zzw200498-hue/stm32-esp8266-iot-gateway/docs/schematic-lceda.pdf

1

2

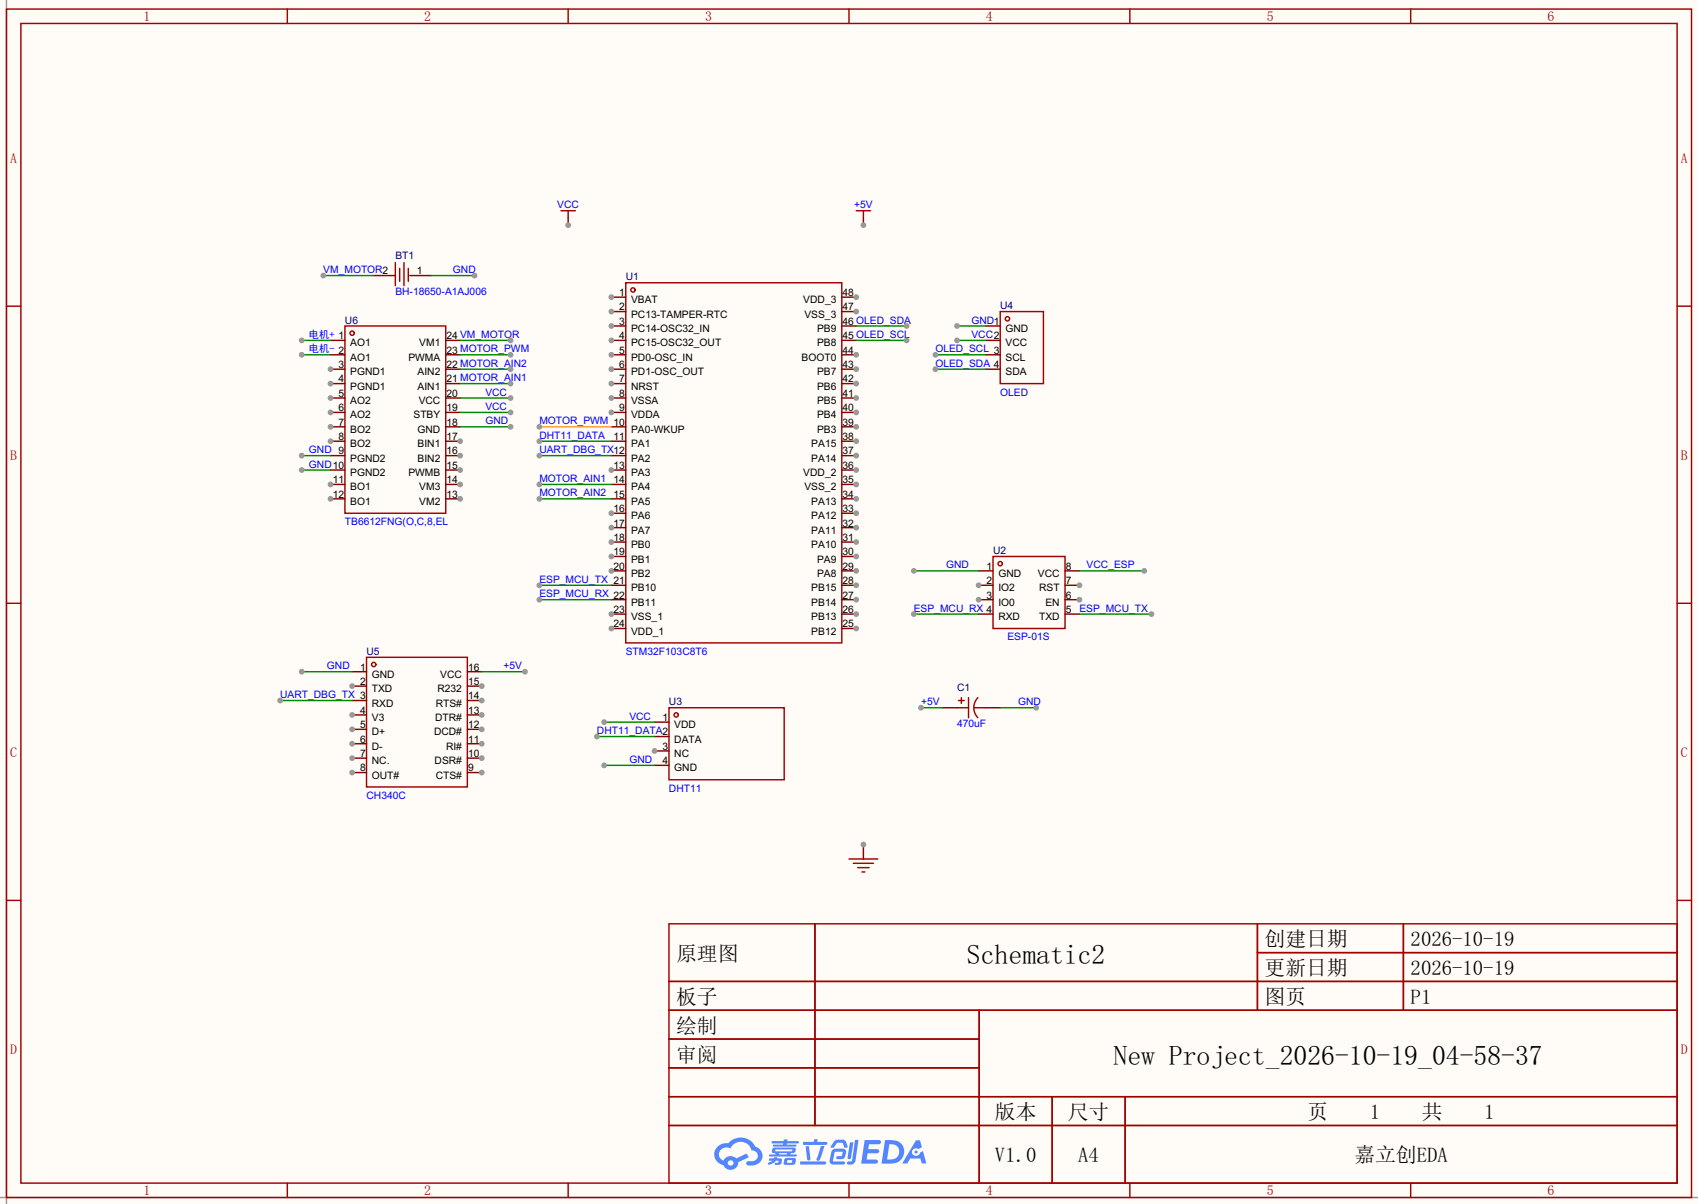
[picture p3: page 1]

ESP_MCU_TX
ESP_MCU_RX
DSR# 10 RI# 11 DCD# 12 DTR# 13 RTS# 14 R232 15 VCC 16

原理图 | Schematic2 | 创建日期 | 2026-10-19

更新日期 | 2026-10-19

板子 | | 图页 | P1
绘制 | | New Project_2026-10-19_04-58-37
审阅

V1.0 | A4 | 嘉立创EDA
