zzw200498-hue/stm32-esp8266-iot-gateway/Hardware/Serial.c

#include "stm32f10x.h"                  // Device header
#include "stdio.h"
#include "stdarg.h"

/*
 * Serial —— 调试串口（USART2，PA2=TX，115200 8N1，只发不收）
 *
 * 为什么不用 USART1：PA9 排针疑似损坏/虚焊，实测发不出数据。
 * 调试口改走 USART2 后，波特率和 ESP 串口统一为 115200，
 * 串口助手不用来回切换。
 * 注意：USART2 挂载在 APB1 总线（USART1 才在 APB2）。
 */
void Serial_Init(void)
{
	RCC_APB1PeriphClockCmd(RCC_APB1Periph_USART2, ENABLE);
	RCC_APB2PeriphClockCmd(RCC_APB2Periph_GPIOA, ENABLE);

	GPIO_InitTypeDef GPIO_InitStructure;
	GPIO_InitStructure.GPIO_Mode = GPIO_Mode_AF_PP;
	GPIO_InitStructure.GPIO_Pin = GPIO_Pin_2;
	GPIO_InitStructure.GPIO_Speed = GPIO_Speed_50MHz;
	GPIO_Init(GPIOA, &GPIO_InitStructure);

	USART_InitTypeDef USART_InitStructure;
	USART_InitStructure.USART_BaudRate = 115200;
	USART_InitStructure.USART_HardwareFlowControl = USART_HardwareFlowControl_None;
	USART_InitStructure.USART_Mode = USART_Mode_Tx;
	USART_InitStructure.USART_Parity = USART_Parity_No;
	USART_InitStructure.USART_StopBits = USART_StopBits_1;
	USART_InitStructure.USART_WordLength = USART_WordLength_8b;
	USART_Init(USART2, &USART_InitStructure);

	USART_Cmd(USART2, ENABLE);
}

void Serial_SendByte(uint8_t Byte)
{
	USART_SendData(USART2, Byte);
	while (USART_GetFlagStatus(USART2, USART_FLAG_TXE) == RESET)
	{
		/* 等待发送寄存器空闲 */
	}
}

void Serial_SendArray(uint8_t *Array, uint16_t Length)
{
	uint16_t i;
	for (i = 0; i < Length; i++)
	{
		Serial_SendByte(Array[i]);
	}
}

void Serial_SendString(char *String)
{
	uint8_t i;
	for (i = 0; String[i] != 0; i++)
	{
		Serial_SendByte(String[i]);
	}
}

uint32_t Serial_Pow(uint32_t x, uint32_t y)
{
	uint32_t Result = 1;
	while (y--)
	{
		Result *= x;
	}
	return Result;
}

void Serial_SendNumber(uint32_t Number, uint8_t Length)
{
	uint8_t i;
	for (i = 0; i < Length; i++)
	{
		Serial_SendByte(Number / Serial_Pow(10, Length - i - 1) % 10 + '0');
	}
}

int fputc(int ch, FILE *f)
{
	Serial_SendByte(ch);
	return ch;
}

void Serial_Printf(char *format, ...)
{
	char String[100];
	va_list arg;
	va_start(arg, format);
	vsprintf(String, format, arg);
	va_end(arg);
	Serial_SendString(String);
}
