zzw200498-hue/stm32-esp8266-iot-gateway/Hardware/Serial.h

#ifndef __SERIAL_H
#define __SERIAL_H

#include "stdio.h"

void Serial_SendByte(uint8_t Byte);
void Serial_Init(void);
void Serial_SendArray(uint8_t *Array,uint16_t Length);
void Serial_SendString(char*String);
void Serial_SendNumber(uint32_t Number,uint8_t Length);
void Serial_Printf(char*format,...);

#endif
