zzw200498-hue/stm32-esp8266-iot-gateway/(commit log)

2026-10-17 STM32F103 + ESP8266 AT driver: WiFi TCP uplink to Linux server
    - USART2 AT driver (send/expect/timeout/retry), rx buffer via IRQ
    - Auto flow: AT handshake -> CWMODE -> CWJAP -> CIPSTART -> report
    - Handles 'no change' reply and 'busy p...' after CWJAP
    - OLED status display with per-step failure code
2026-10-17 docs: add schematic diagram
2026-10-18 docs: replace schematic with hand-drawn version (LCEDA)
2026-10-18 feat: 完成温控风扇物联网网关（双车道）
    - DHT11 温湿度采集（判位阈值修正为 15，解决全 0 假通过）
    - OLED 显示温湿度/风扇档位/网络状态
    - 温控风扇：温度分档调速（PA0 PWM + PA4/PA5 方向）
    - 调试串口迁移至 USART2(PA2@115200)，USART1 弃用
    - ESP8266 迁移至 USART3(PB10/PB11)
    - 上行：温湿度 JSON 每 4.5s 上报；下行：FAN=ON/OFF/AUTO 远程控制
    - 私有配置拆分至 config.h（gitignore），仓库仅保留 config.h.example 模板
    - 新增 VSCode+CMake 构建配置
2026-10-18 docs: 实物原型照片 + README 更新为完整项目文档
    - 上传面包板实物照片（温控风扇 + OLED 显示 NET OK）
    - 收录立创 EDA 原理图（PDF/SVG）
    - README 重写：功能清单、双车道架构、串口分配、踩坑记录
    - 历史文档统一移入 docs/ 目录
2026-10-18 docs: 原理图修订——补全 ESP 上拉/第二路稳压/MCU 电源/电机输出
    - ESP-01S: EN/RST/IO0/IO2 各 10K 上拉至 VCC_ESP
    - 新增第二路 AMS1117-3.3 独立供 ESP，输出 470uF 滤波
    - MCU: VBAT/VDDA/VDD_2/VSS_2/VSSA 接电源，NRST/BOOT0 10K 配置
    - TB6612: 电机经 CN1 接 AO1/AO2，VM1/2/3 全接，PWMB 拉低关断 B 通道
    - PGND 并入 GND
2026-10-19 docs: 全项目开发报告 README + 合并 Linux 服务端到 server/
    - README 重写为完整开发报告：四阶段开发历程、BOM、7 条踩坑记录、
    产品式使用说明书、原理图/实物/运行截图（简易图→立创EDA→实物→截图）
    - git subtree 合并 fan-iot-server 到 server/，固件与服务端单仓库交付
    - 修正网络转发描述：实测为 VMware vmnetnat.conf，非 netsh portproxy
